Alexmir888/battery-monitor_poit/images/powerbanks.jpg

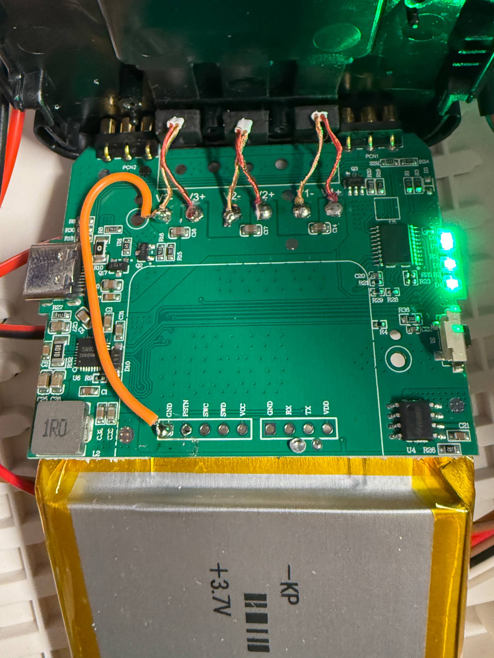
images/powerbanks.jpg
