Alexmir888/battery-monitor_poit/images/voltage_divider.jpg

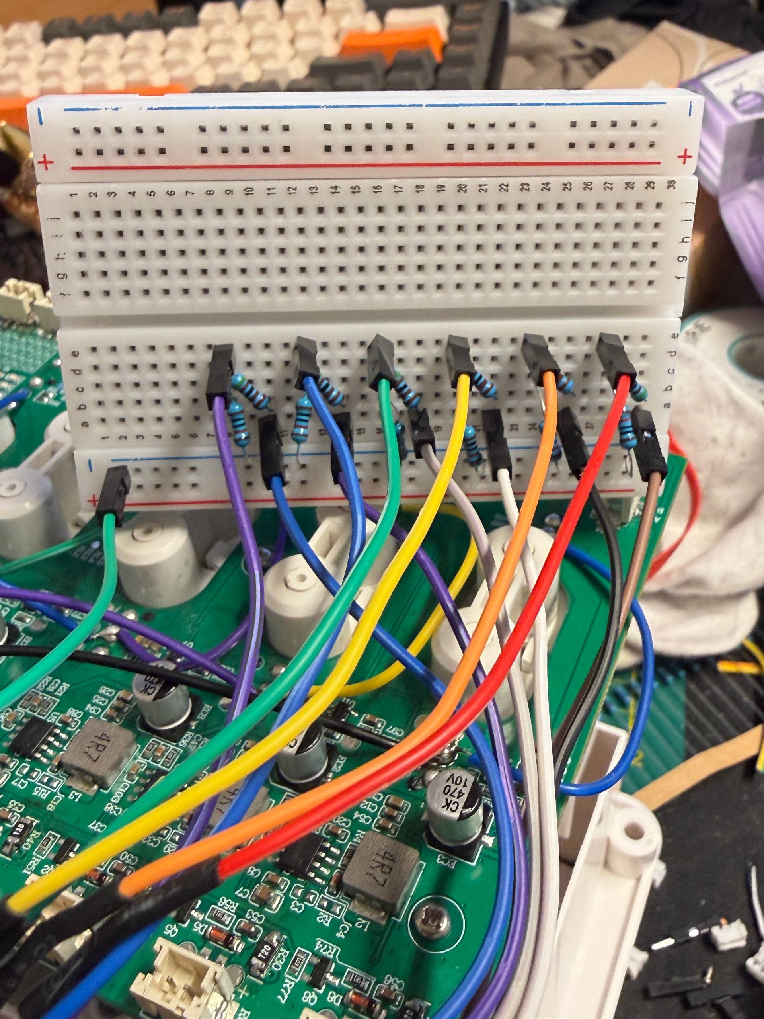
images/voltage_divider.jpg
