Alexmir888/battery-monitor_poit/circuit_diagram.pdf

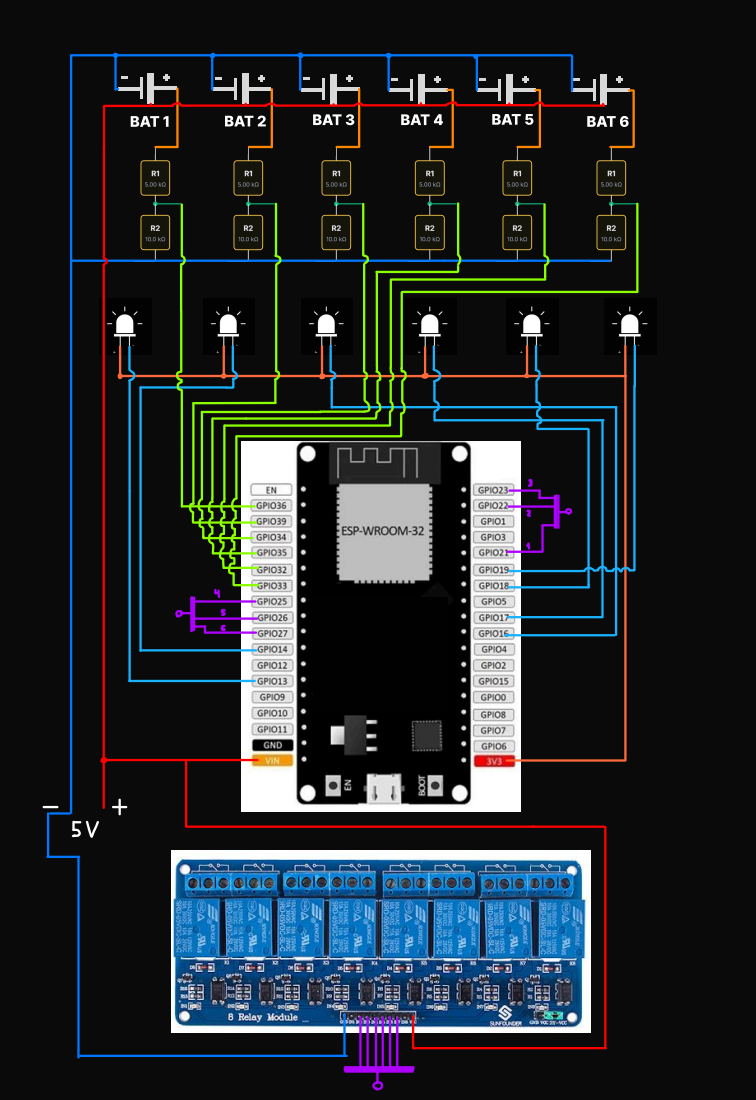
[picture p7: page 1]
BAT 1; BAT 2; BAT 3; BAT 4; BAT 5; BAT 6
