Alexmir888/battery-monitor_poit/firmware/main/config.h

#ifndef SECRETS_H
#define SECRETS_H

// ============================================================
// KONFIGURÁCIA – SKOPÍRUJTE TENTO SÚBOR AKO config.h
// a vyplňte vlastné hodnoty.
// ============================================================

const char* ssid       = "qwer";
const char* password   = "12345678";
const char* serverName = "http://192.168.11.147//api/data";
//                              ↑ nahraďte IP adresou vášho Flask servera
//                                (zistíte príkazom: ipconfig / ip a)

#endif
